OLIMEX/Minibot/README.md

# Minibot
Small Educational Robot programmable with Arduino, with two motors and sensors to follow line or escape from labyrinth

## LICENSE
* Software License is GPL3
* Hardware License is Apache 2.0
* Documentation License is CC-BY-SA3.0 (https://creativecommons.org/licenses/by-sa/3.0/)
