OLIMEX/Minibot/HARDWARE/MiniBot_RevA_BOM.ods

Designation | Quantity | Designator | Package
RED 3mm | 3 | LED1, LED2, LED3 | LED-3mm-PTH-KA
ФОТОТРАНЗИСТОР IR L932P3BT | 4 | Q1, Q2, Q3, Q4 | LED-3mm-PTH-KA
ATTINY85-20PU | 1 | U1 | SO-8_208mil
СЪЕДИНИТЕЛ CR2032H PTH | 1 | BAT1 | CR2032H_PTH
DW02S | 1 | BAT_CON2 | LIPO_BAT_VERTICAL_DW02S
SMD КОНД 1206 22 UF 25VDC X7R | 1 | C1 | C_1206_5MIL_DWS
VIBRATING-MOTOR 10MM 3V | 2 | CON1, CON2 | MIC-TERES
SMD ТРАНЗИСТОР WNM2016-3/TR | 2 | FET1,FET2 | SOT23
SMD РЕЗ 1206 4.7 K 5% | 2 | R1,R5 | R_1206_5MIL_DWS
SMD РЕЗ 1206 180R 5% | 3 | R2,R3,R4 | R_1206_5MIL_DWS
бели гумени крачета | 2
термошлаух 4мм | 1 | 2 см
кабели два проводника | 2 | 2 см
рейка HN1x9 | 1
