OLIMEX/Minibot/HARDWARE/charger/MiniBot_charger_RevA_BOM.ods

Designation | Quantity | Designator | Package
RED 0603 | 1 | LED1 | LED0603
BL4054-42TRPN | 1 | U1 | SOT23-5
SMD СЪЕДИНИТЕЛ MISB-SWMM-5B-LF | 1 | USB1
DW02S | 1 | BAT_CON2 | LIPO_BAT_VERTICAL_DW02S
SMD КОНД 0603 2.2 UF 6.3VDC X7R | 2 | C1, C2 | C_0603_5MIL_DWS
SMD РЕЗ 0603 22R 5% | 2 | R2,R3 | R_0603_5MIL_DWS
SMD РЕЗ 0603 1.5K 5% | 1 | R1,R5 | R_0603_5MIL_DWS
SMD РЕЗ 0603 10K 5% | 1 | R4 | R_0603_5MIL_DWS
F-D-1x08-LF | 1 | CON1
