OLIMEX/Minibot/HARDWARE/MiniBot_RevA.pdf

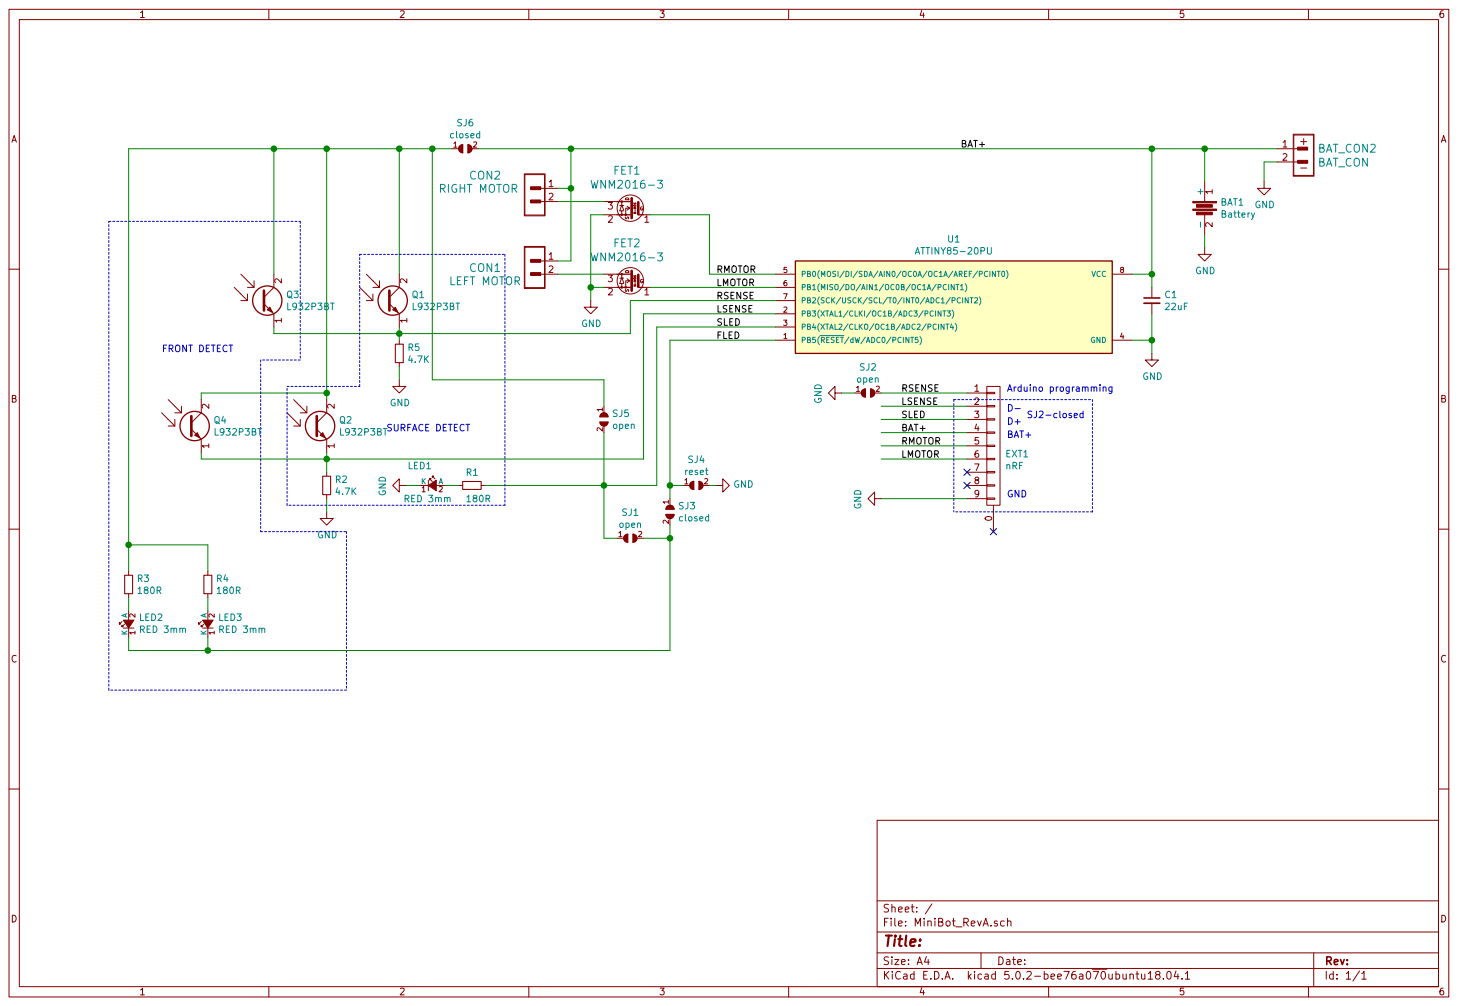
[picture p1: page 1]

-2 BAT1 Battery GND GND GND
