OLIMEX/Minibot/HARDWARE/charger/MiniBot_charger_RevA.pdf

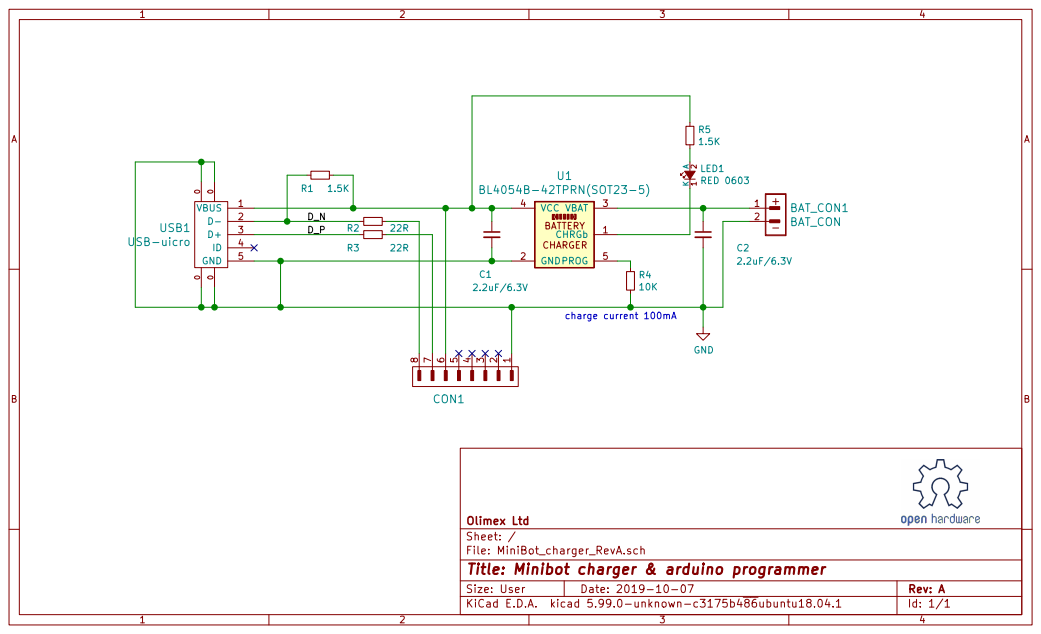
[picture p2: page 1]

File: MiniBot_charger_RevA.sch Sheet: / Olimex Ltd

Id: 1/1 Title: Minibot charger & arduino programmer
