OLIMEX/Minibot/HARDWARE/charger/MiniBot_charger_RevA.kicad_pcb

## KiCad design HARDWARE/charger/MiniBot_charger_RevA.kicad_pcb (2019-10-07)

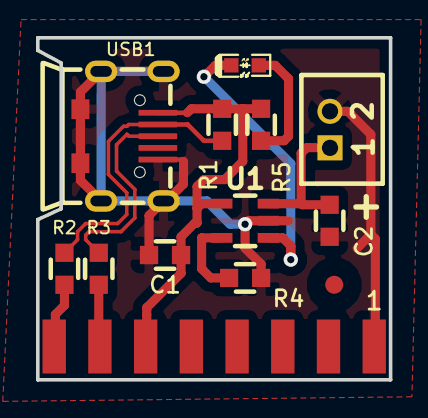
[picture p3: board MiniBot_charger_RevA.kicad_pcb from above]

Board: 2 copper layers, 19.6 x 19.0 mm, 13 parts (0 on the bottom side), 10 nets.

Parts:
BAT_CON1: BAT_CON; LIPO_BAT_VERTICAL_DW02S
C1, C2: 2.2uF/6.3V; C_0603_5MIL_DWS
CON1: CON8; SIP8_SMD
LED1: LED_Small; LED_0603_KA
R1: 1.5K; R_0603_5MIL_DWS
R2, R3: 22R; R_0603_5MIL_DWS
R4: 13K_1%; R_0603_5MIL_DWS
R5: 10K; R_0603_5MIL_DWS
Ref*: Val**; Fiducial1x3_transp
U1: BL4054B-42TPRN(SOT23-5); SOT-23-5
USB1: USB-uicro; USB-MICRO_MISB-SWMM-5B_LF

Connections:
/D_N: R1.2, R2.2, USB1.2
/D_P: R3.2, USB1.3
GND: BAT_CON1.2, C1.2, C2.2, CON1.1, R4.2, U1.2, USB1.0, USB1.5
unnamed: BAT_CON1.1, C2.1, U1.3
unnamed: C1.1, CON1.6, R1.1, R5.1, U1.4, USB1.1
unnamed: CON1.7, R3.1
unnamed: CON1.8, R2.1
unnamed: LED1.1, U1.1
unnamed: LED1.2, R5.2
unnamed: R4.1, U1.5
