OLIMEX/Minibot/HARDWARE/MiniBot_RevA.kicad_pcb

## KiCad design HARDWARE/MiniBot_RevA.kicad_pcb (2019-06-11)

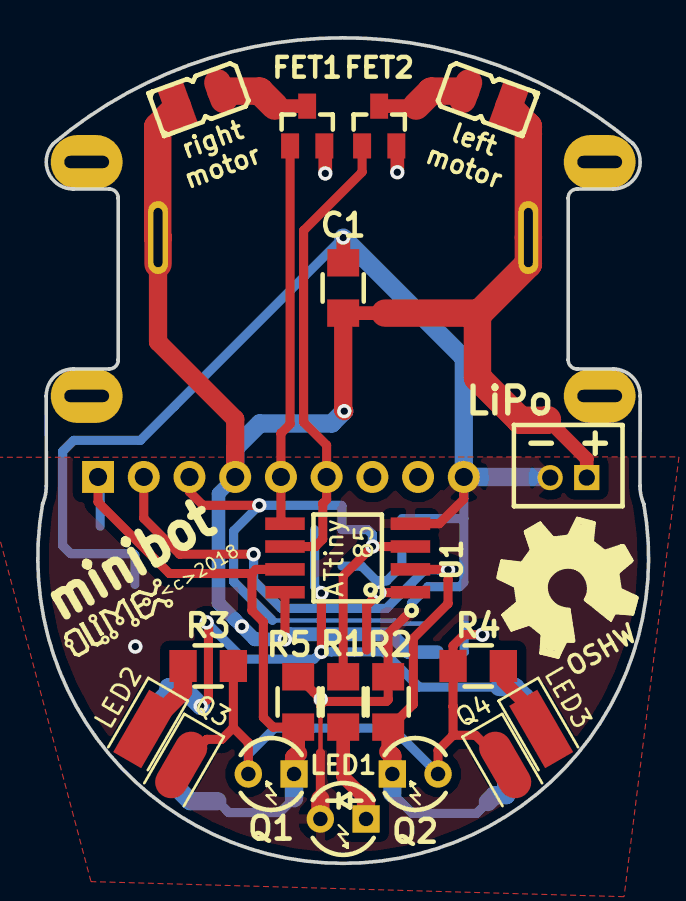
[picture p4: board MiniBot_RevA.kicad_pcb from above]

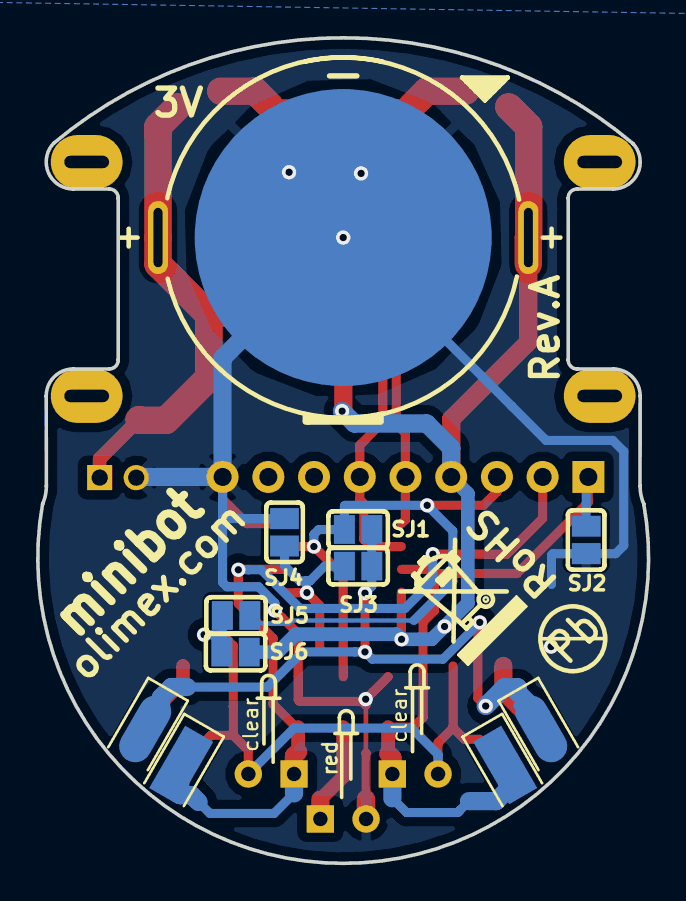
[picture p5: board MiniBot_RevA.kicad_pcb from below]

Board: 2 copper layers, 33.9 x 45.9 mm, 27 parts (7 on the bottom side), 15 nets.

Parts:
BAT1: Battery; CR2032H_PTH
BAT_CON2: BAT_CON; LIPO_BAT_VERTICAL_DW02S
C1: C_Small; C_1206_5MIL_DWS
CON1: LEFT MOTOR; MIC-TERES
CON2: RIGHT MOTOR; MIC-TERES
EXT1: nRF; HN1x9
FET1, FET2: WNM2016-3; SOT23
LED1: RED 3mm; LED-3mm-PTH-KA
LED2, LED3: RED 3mm; LED-EDGE
Q1, Q2: L342; LED-3mm-PTH-KA
Q3, Q4: L342; L34x-EDGE
R1, R3, R4: 1K; R_1206_5MIL_DWS
R2, R5: 3.3K; R_1206_5MIL_DWS
SJ1: leds_join; SJ
SJ2: arduino; SJ
SJ3, SJ5, SJ6: eco; SJ
SJ4: reset; SJ
U1: ATTINY85-20PU; SO-8_208mil

Connections:
/BAT+: BAT1.1, BAT_CON2.1, C1.1, CON1.1, CON2.1, EXT1.4, SJ6.2, U1.8
/FLED: SJ3.1, SJ4.1, U1.1
/LMOTOR: EXT1.6, FET2.1, U1.6
/LSENSE: EXT1.2, Q2.1, Q4.1, R2.1, U1.2
/RMOTOR: EXT1.5, FET1.1, U1.5
/RSENSE: EXT1.1, Q1.1, Q3.1, R5.1, SJ2.2, U1.7
/SLED: EXT1.3, R1.1, SJ1.1, SJ5.2, U1.3
GND: BAT1.2, BAT_CON2.2, C1.2, EXT1.9, FET1.2, FET2.2, LED1.1, R2.2, R5.2, SJ2.1, SJ4.2, U1.4
unnamed: CON1.2, FET2.3
unnamed: CON2.2, FET1.3
unnamed: LED1.2, R1.2
unnamed: LED2.1, LED3.1, SJ1.2, SJ3.2
unnamed: LED2.2, R3.2
unnamed: LED3.2, R4.2
unnamed: Q1.2, Q2.2, Q3.2, Q4.2, R3.1, R4.1, SJ5.1, SJ6.1
