OLIMEX/Minibot/(threads)

Thread 1 (2025-01-30):

Errors in documentation

KingBBQ, 2025-01-30:
component locations: R1 is 180 ohm, not 1k. R4 and R3 are the same.
Jumper: its SJ6 NOT SJ5 according to the schematics. right in the picture, wrong in the text.

great bot anyways - thanks!

DanKoloff, 2025-01-31:
Thanks, it should be fixed now in this commit:

https://github.com/OLIMEX/Minibot/commit/ebf0419795b32a59a2dfd3a6aff0802dccd31dc5

Let me know if you spot other discrepancies.

KingBBQ, 2025-02-01:
thanks 👍  that was all i found, thanks for the quick fix

Closed 2025-02-01.
